v9938/RetroVGen/(list of files, cad)

Other CAD files:
PCB/Case/Case(lc115h-f2).dwg
