v9938/RetroVGen/PCB/Schematic/Schematic Design.pdf

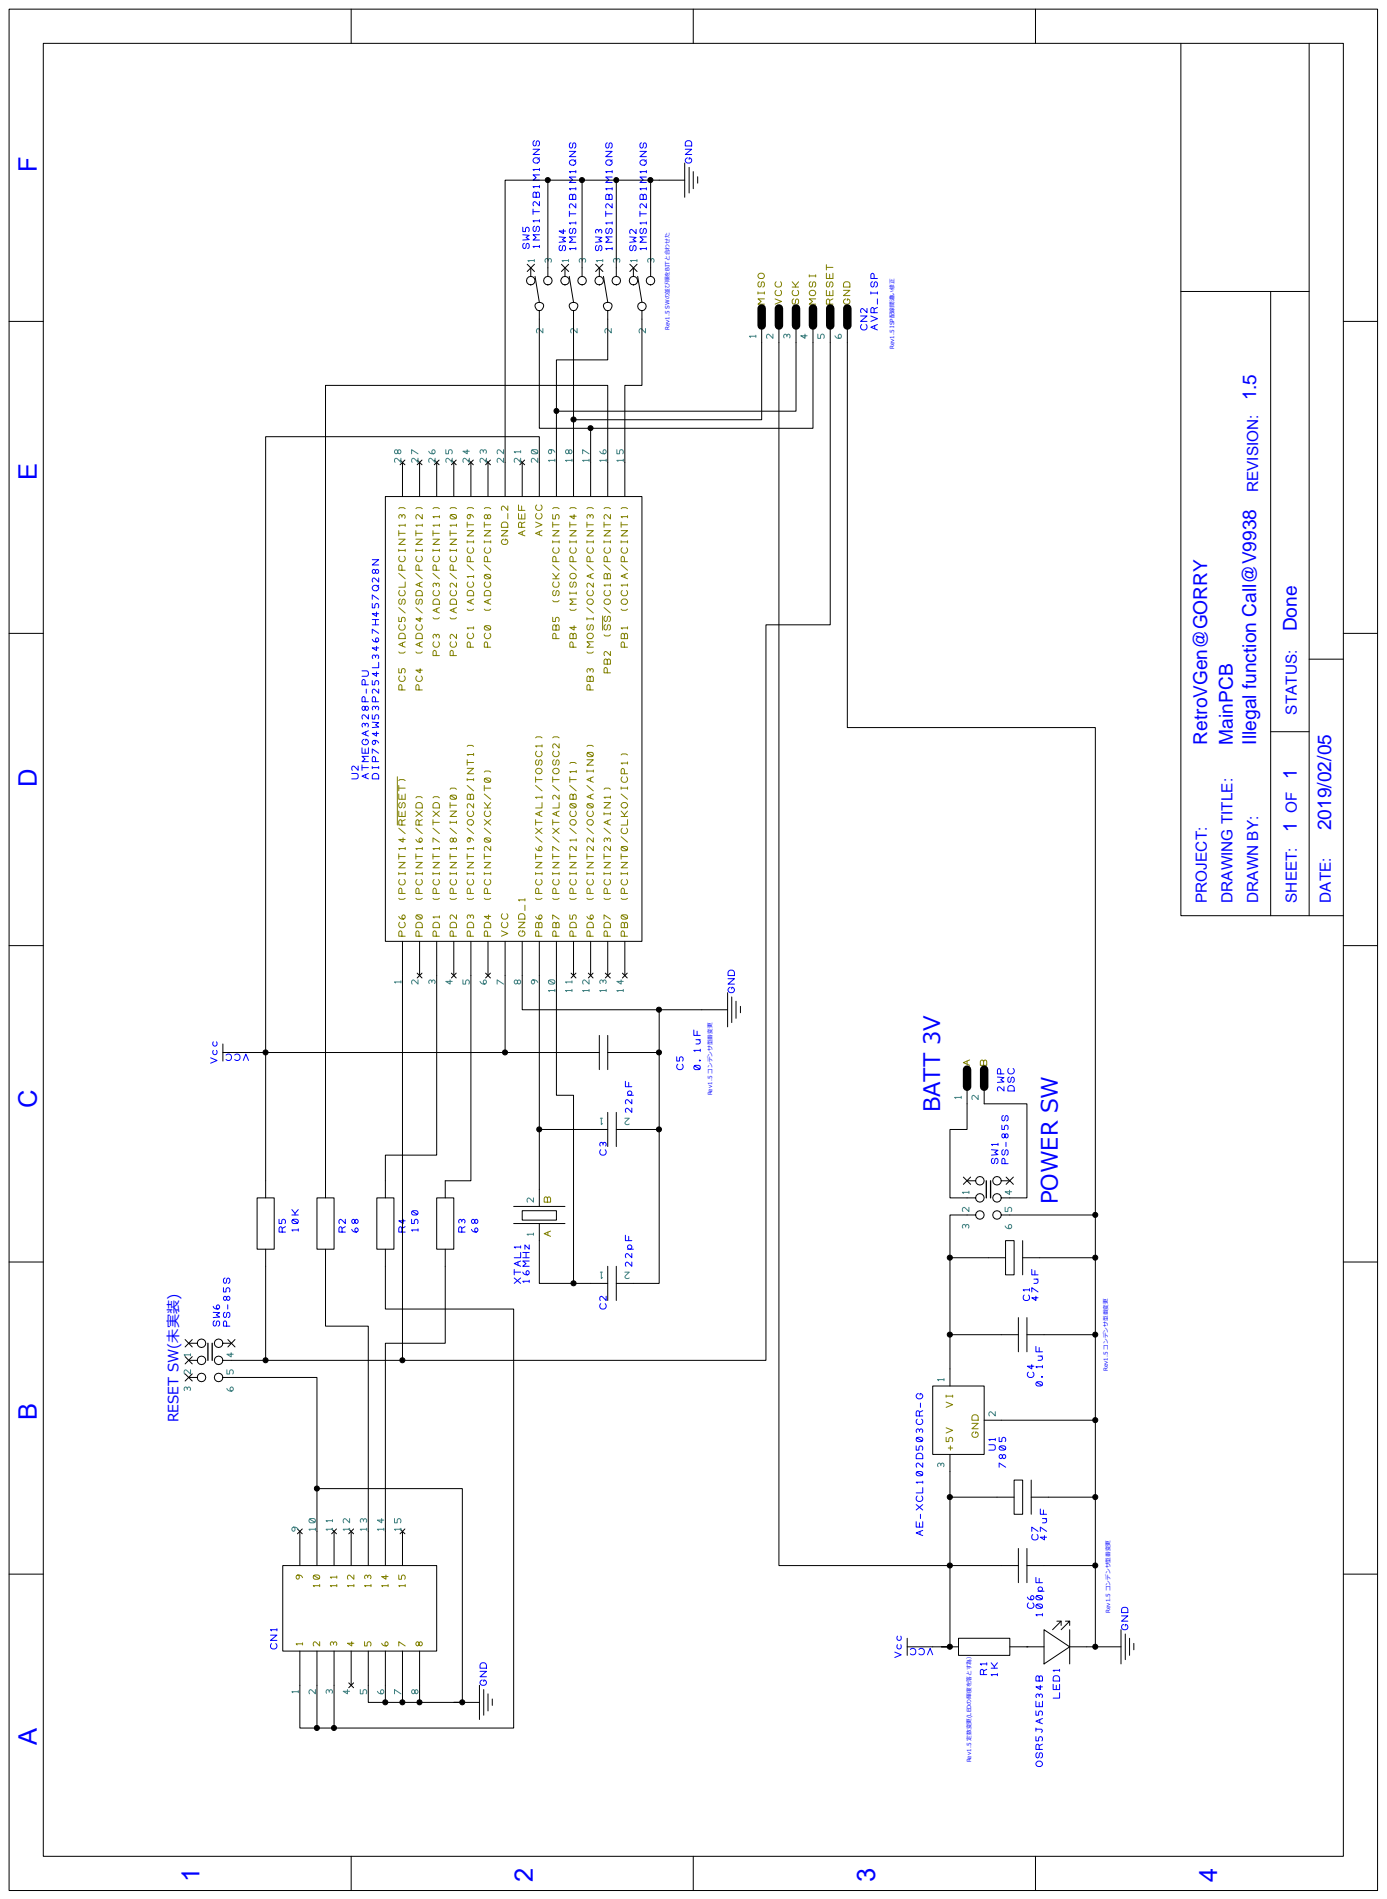
[picture p1: page 1]
BATT 3V; POWER SW; RetroVGen@GORRY; MainPCB; Done; Rev1.5 コンデンサ型番変更; Rev1.5 ISP配線間違い修正; Rev1.5 コンデンサ型番変更 Rev1.5 コンデンサ型番変更; Rev1.5 定数変更(LEDの輝度を落とす為）; Rev1.5 SWの並び順をBITと合わせた

Illegal function Call@V9938

RESET SW(未実装)
