v9938/RetroVGen/PCB/Case/Case(lc115h-f2).pdf

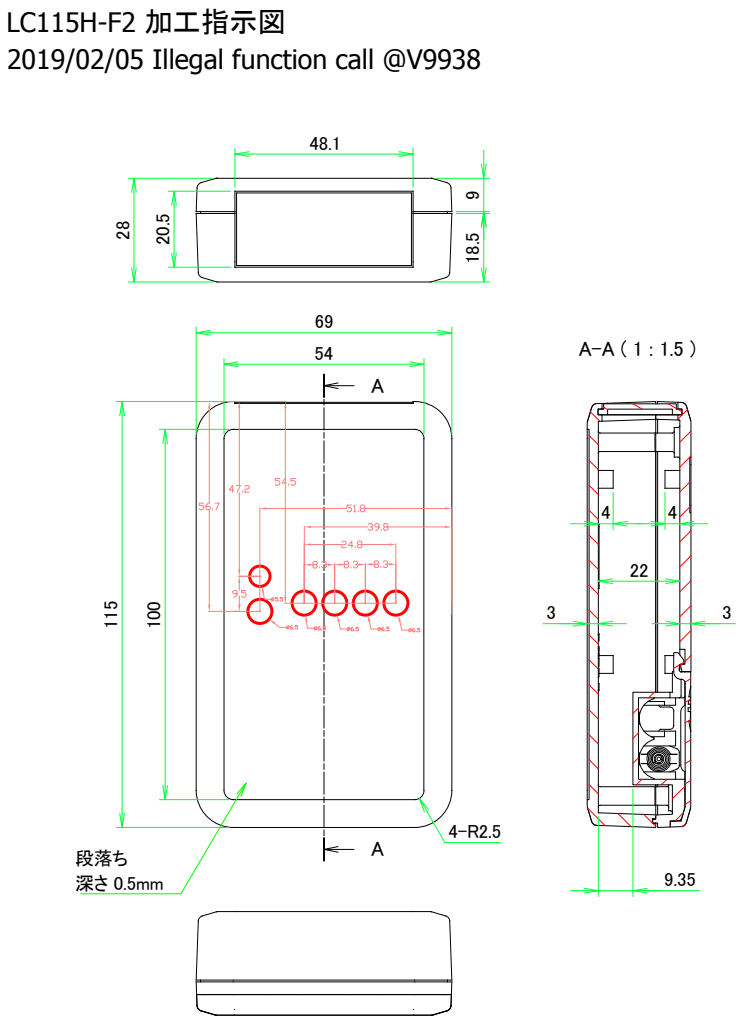
[picture p2: page 1]
段落ち 深さ 0.5mm

LC115H-F2 加工指示図
2019/02/05 Illegal function call @V9938
